devstdin/tt08-ldo-bg-ref-osc/README.md

 

# Analog Building Blocks for Tiny Tapeout 8

- [Bandgap](https://devstdin.github.io/sky130artefacts_tt08/bmbg/bmbg/)
  - [OTA](https://devstdin.github.io/sky130artefacts_tt08/bmbg/bmbgota/)
- [Ref. Current Source](https://devstdin.github.io/sky130artefacts_tt08/vthref_tt/vthref/)
- [LDO](https://devstdin.github.io/sky130artefacts_tt08/ldo/ldo/)
  - [OPAMP](https://devstdin.github.io/sky130artefacts_tt08/ldo/ldoota/)
- [Ring Oscillator](https://devstdin.github.io/sky130artefacts_tt08/riosc/riosc/)

## What is Tiny Tapeout?

Tiny Tapeout is an educational project that aims to make it easier and cheaper than ever to get your digital designs manufactured on a real chip.

To learn more and get started, visit https://tinytapeout.com.
